ppedropimenta/connected-heart/hardware/kicad/preview/board-bottom.png

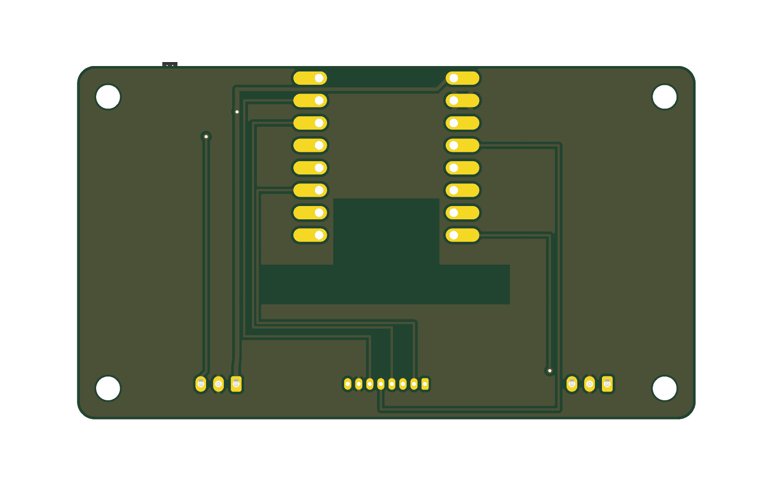
hardware/kicad/preview/board-bottom.png
