ppedropimenta/connected-heart/hardware/kicad/preview/board-top.png

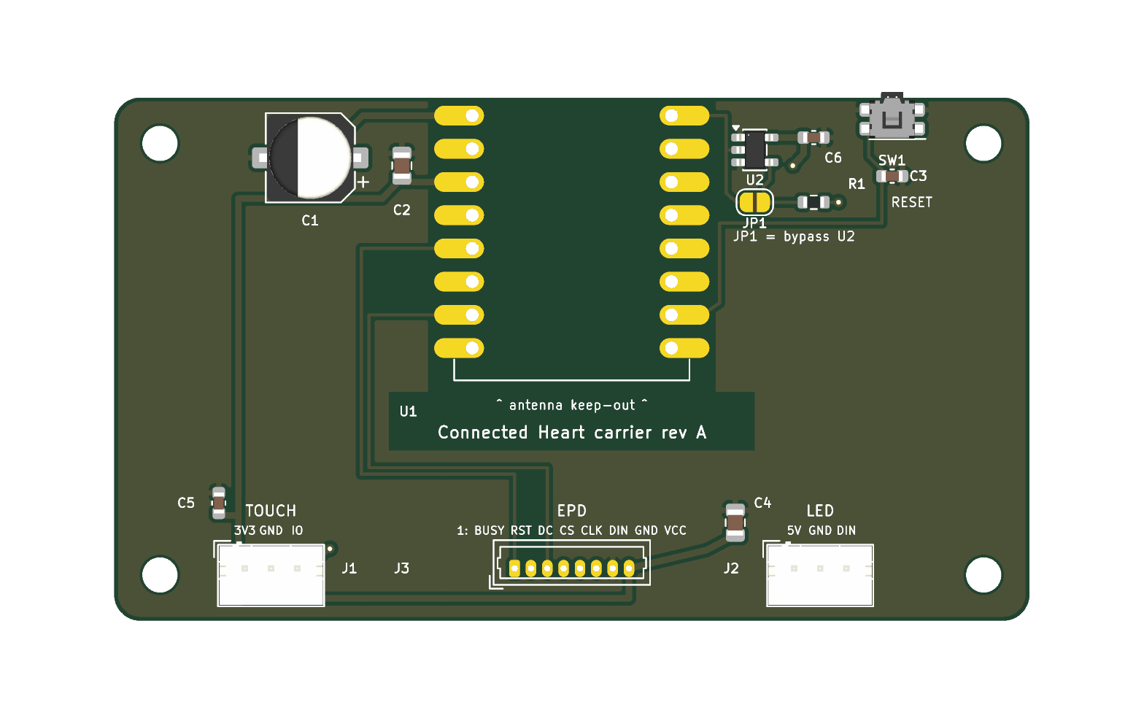
hardware/kicad/preview/board-top.png
