ppedropimenta/connected-heart/hardware/kicad/preview/schematic.pdf

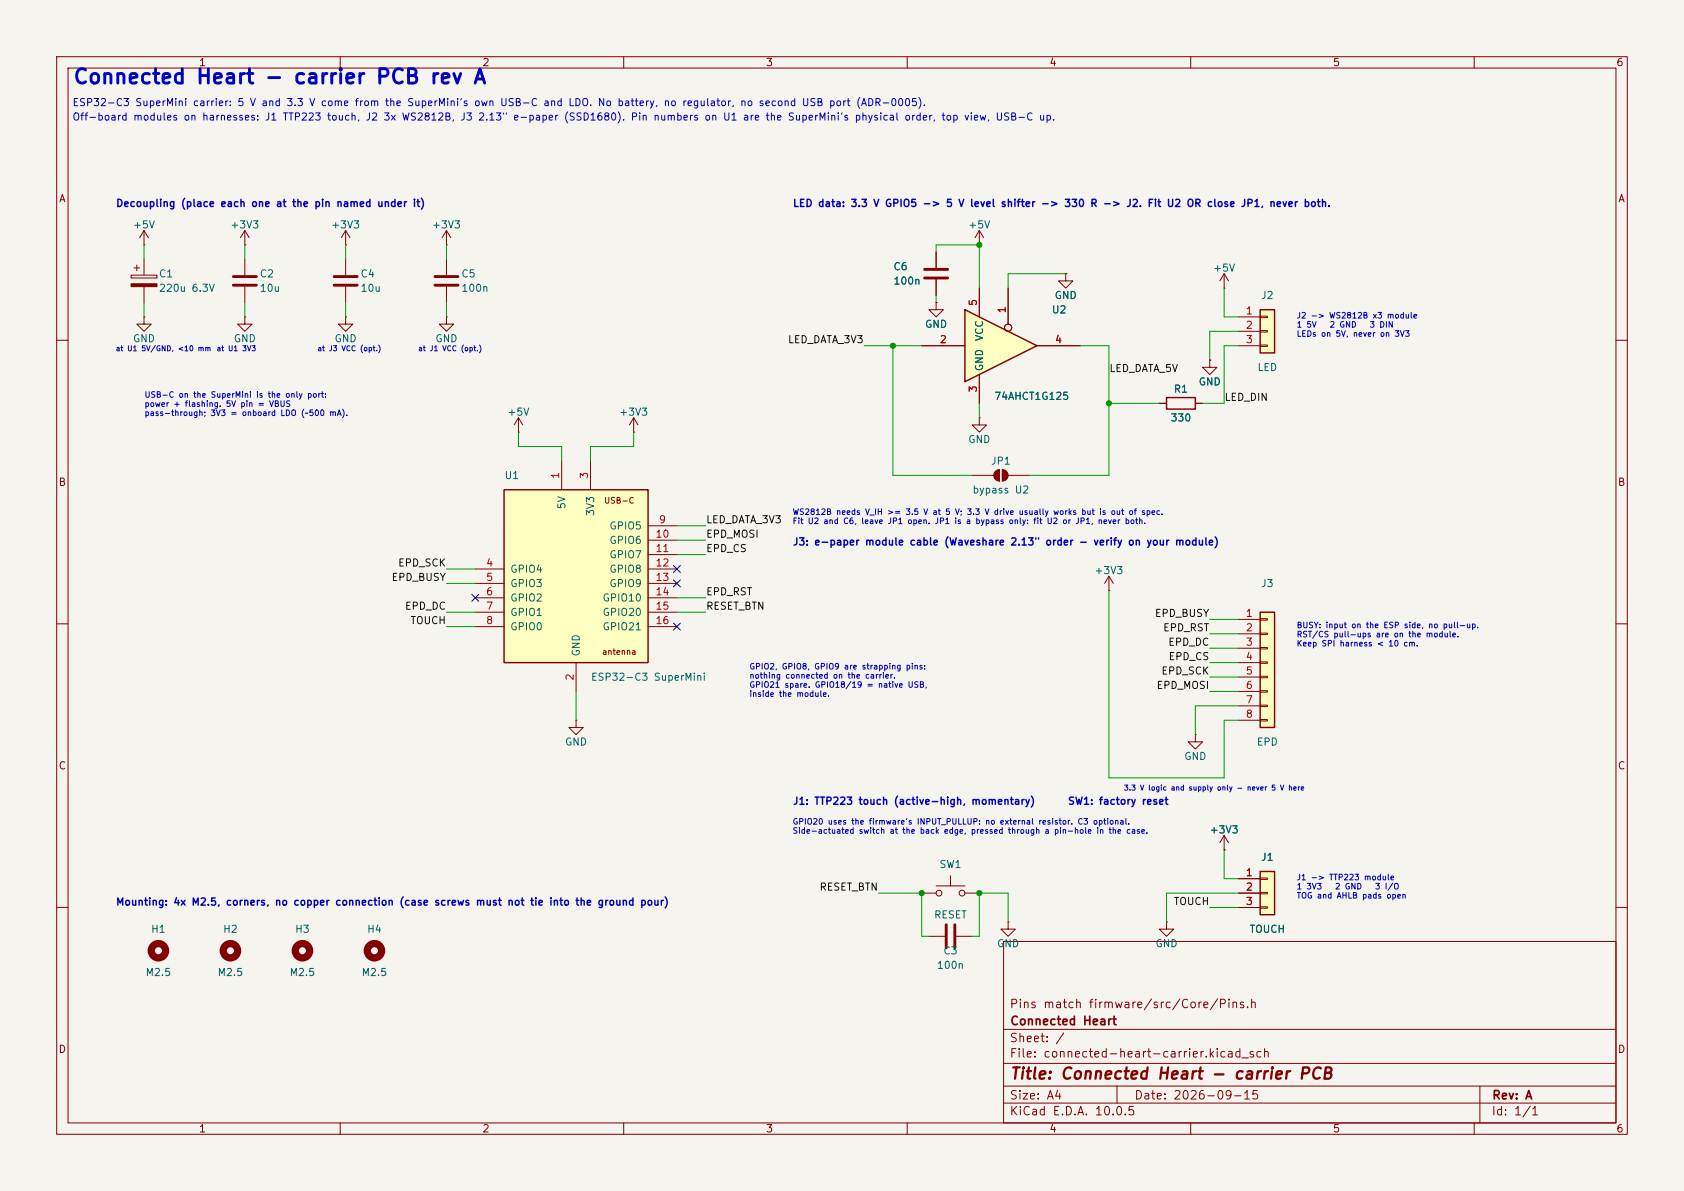
[picture p7: page 1]

pass-through; 3V3 = onboard LDO (~500 mA). at U1 3V3 Connected Heart - carrier PCB rev A
GND +5V GND

inside the module. J3: e-paper module cable (Waveshare 2.13" order - verify on your module) WS2812B needs V_IH >= 3.5 V at 5 V; 3.3 V drive usually works but is out of spec. Fit U2 and C6, leave JP1 open. JP1 is a bypass only: fit U2 or JP1, never both. ESP32-C3 SuperMini carrier: 5 V and 3.3 V come from the SuperMini's own USB-C and LDO. No battery, no regulator, no second USB port (ADR-0005).
Off-board modules on harnesses: J1 TTP223 touch, J2 3x WS2812B, J3 2.13" e-paper (SSD1680). Pin numbers on U1 are the SuperMini's physical order, top view, USB-C up. Decoupling (place each one at the pin named under it)

LEDs on 5V, never on 3V3 GPIO2, GPIO8, GPIO9 are strapping pins: nothing connected on the carrier. GPIO21 spare. GPIO18/19 = native USB,

TOG and AHLB pads open

Pins match firmware/src/Core/Pins.h
Connected Heart
Sheet: /
File: connected-heart-carrier.kicad_sch
Title: Connected Heart - carrier PCB

Size: A4 | Rev: A
KiCad E.D.A. 10.0.5 | Id: 1/1
