ppedropimenta/connected-heart/hardware/kicad/connected-heart-carrier.kicad_sch

## KiCad design hardware/kicad/connected-heart-carrier.kicad_sch (2026-10-23)

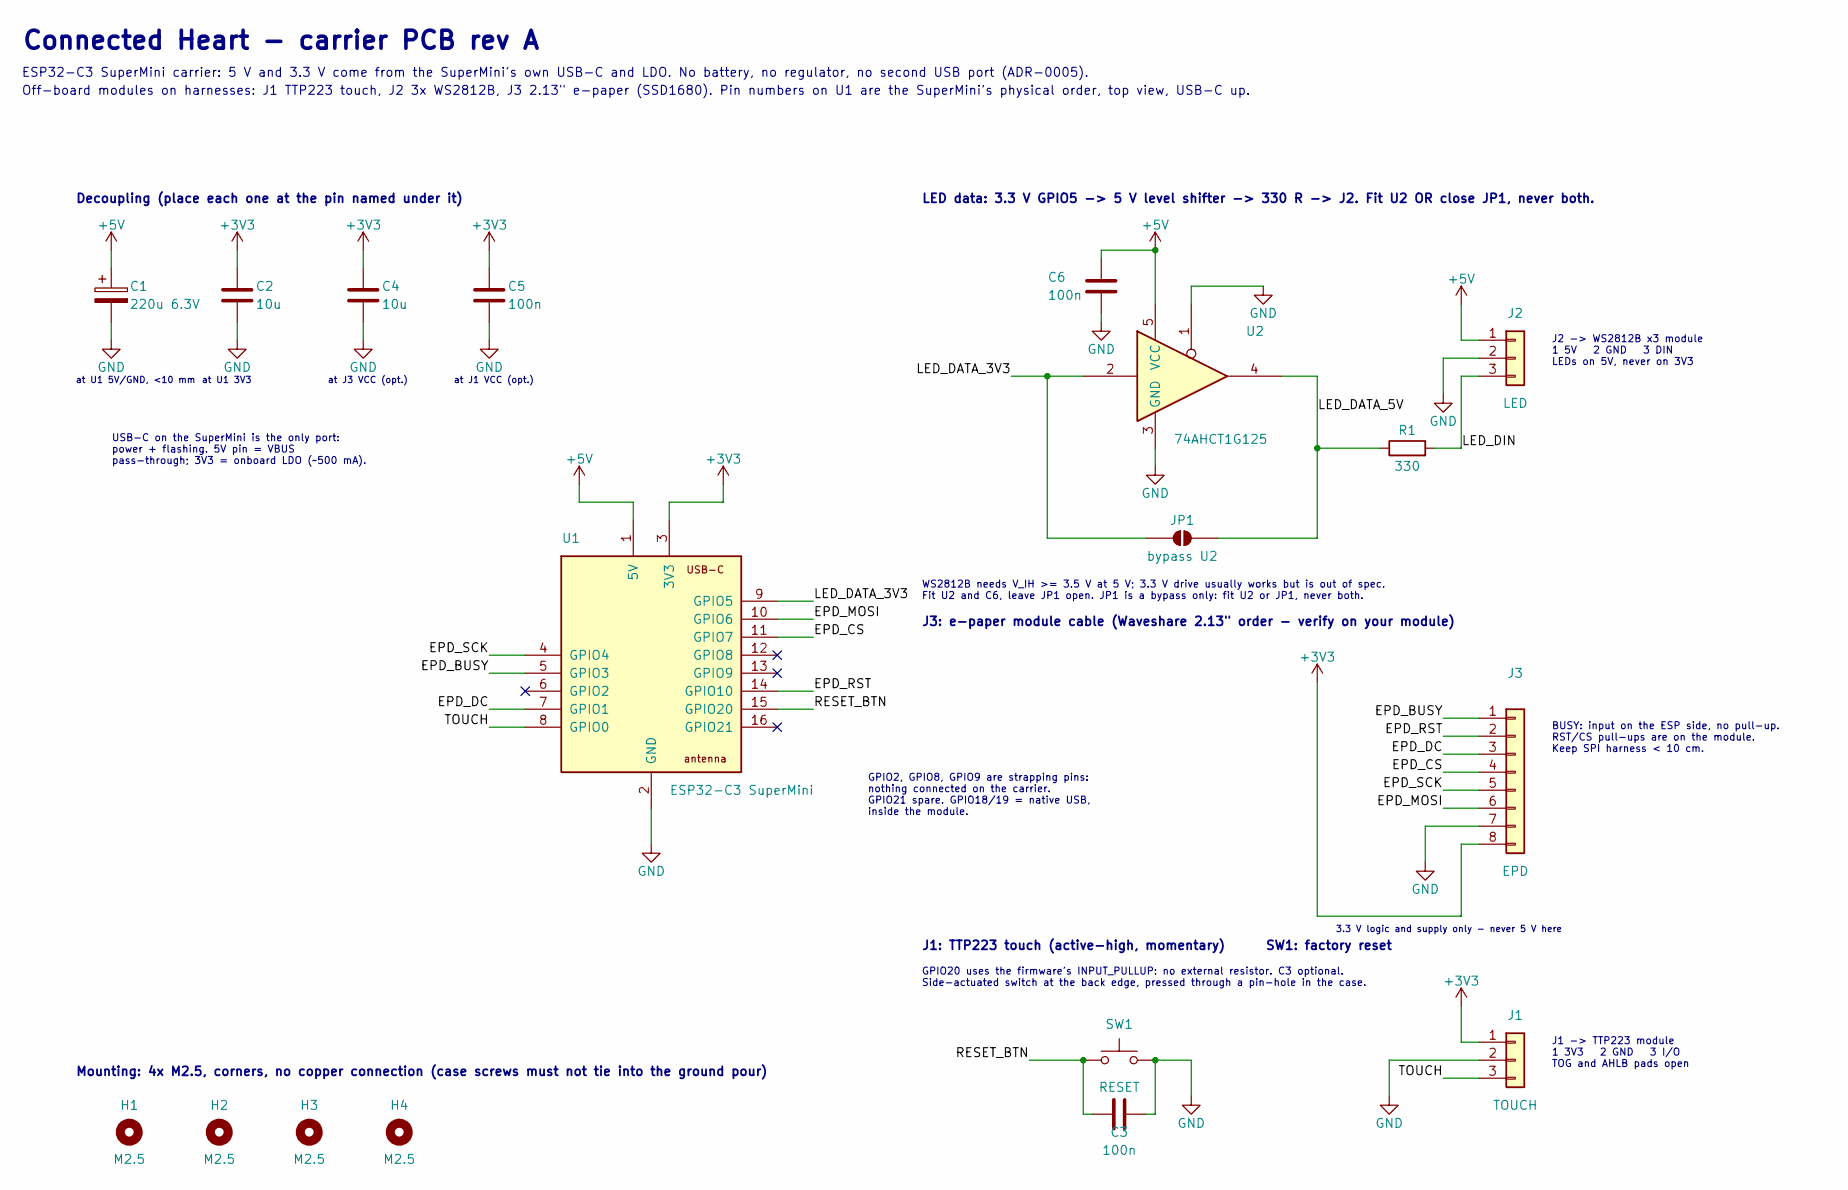
[picture p8: schematic connected-heart-carrier.kicad_sch]

Parts:
C1: 220u 6.3V; CP_Elec_6.3x5.8
C2, C4: 10u; C_0805_2012Metric
C3, C5, C6: 100n; C_0603_1608Metric
H1, H2, H3, H4: M2.5; MountingHole_2.7mm_M2.5
J1: TOUCH; JST_PH_B3B-PH-K_1x03_P2.00mm_Vertical
J2: LED; JST_PH_B3B-PH-K_1x03_P2.00mm_Vertical
J3: EPD; Molex_PicoBlade_53047-0810_1x08_P1.25mm_Vertical
JP1: bypass U2; SolderJumper-2_P1.3mm_Open_RoundedPad1.0x1.5mm
R1: 330; R_0603_1608Metric
SW1: RESET; SW_SPST_EVQP7A
U1: ESP32-C3 SuperMini; ESP32-C3_SuperMini
U2: 74AHCT1G125; SOT-23-5

Connections:
+3V3: C2.1, C4.1, C5.1, J1.1, J3.8, U1.3 (3V3)
+5V: C1.1, C6.1, J2.1, U1.1 (5V), U2.5 (VCC)
EPD_BUSY: J3.1, U1.5 (GPIO3)
EPD_CS: J3.4, U1.11 (GPIO7)
EPD_DC: J3.3, U1.7 (GPIO1)
EPD_MOSI: J3.6, U1.10 (GPIO6)
EPD_RST: J3.2, U1.14 (GPIO10)
EPD_SCK: J3.5, U1.4 (GPIO4)
GND: C1.2, C2.2, C3.2, C4.2, C5.2, C6.2, J1.2, J2.2, J3.7, SW1.2, U1.2 (GND), U2.1, U2.3 (GND)
LED_DATA_3V3: JP1.1 (A), U1.9 (GPIO5), U2.2
LED_DATA_5V: JP1.2 (B), R1.1, U2.4
LED_DIN: J2.3, R1.2
RESET_BTN: C3.1, SW1.1, U1.15 (GPIO20)
TOUCH: J1.3, U1.8 (GPIO0)

Notes on the sheet:
Connected Heart - carrier PCB rev A
ESP32-C3 SuperMini carrier: 5 V and 3.3 V come from the SuperMini's own USB-C and LDO. No battery, no regulator, no second USB port (ADR-0005).
Off-board modules on harnesses: J1 TTP223 touch, J2 3x WS2812B, J3 2.13" e-paper (SSD1680). Pin numbers on U1 are the SuperMini's physical order, top view, USB-C up.
GPIO2, GPIO8, GPIO9 are strapping pins: nothing connected on the carrier. GPIO21 spare. GPIO18/19 = native USB, inside the module.
USB-C on the SuperMini is the only port: power + flashing. 5V pin = VBUS pass-through; 3V3 = onboard LDO (~500 mA).
Decoupling (place each one at the pin named under it)
at U1 5V/GND, <10 mm
at U1 3V3
at J3 VCC (opt.)
at J1 VCC (opt.)
LED data: 3.3 V GPIO5 -> 5 V level shifter -> 330 R -> J2. Fit U2 OR close JP1, never both.
J2 -> WS2812B x3 module 1 5V 2 GND 3 DIN LEDs on 5V, never on 3V3
WS2812B needs V_IH >= 3.5 V at 5 V; 3.3 V drive usually works but is out of spec. Fit U2 and C6, leave JP1 open. JP1 is a bypass only: fit U2 or JP1, never both.
J3: e-paper module cable (Waveshare 2.13" order - verify on your module)
BUSY: input on the ESP side, no pull-up. RST/CS pull-ups are on the module. Keep SPI harness < 10 cm.
3.3 V logic and supply only - never 5 V here
J1: TTP223 touch (active-high, momentary) SW1: factory reset
J1 -> TTP223 module 1 3V3 2 GND 3 I/O TOG and AHLB pads open
GPIO20 uses the firmware's INPUT_PULLUP: no external resistor. C3 optional. Side-actuated switch at the back edge, pressed through a pin-hole in the case.
Mounting: 4x M2.5, corners, no copper connection (case screws must not tie into the ground pour)
