ppedropimenta/connected-heart/(commit log)

2026-07-25 Initial ESP32-C3 PlatformIO setup
2026-07-25 Core modules and LED control implemented
2026-09-10 Split message domain model: Feeling apart from kind, drop the heap
    MessageType conflated which feeling a message carries with where its
    text comes from, which produced a dead catalog case and let a
    default-constructed HeartMessage exist only to be rejected. Feeling
    now carries just the five sentiments, MessageKind distinguishes a
    Custom Message from a Predefined one, and HeartMessage exposes two
    constructors instead of a default one, so an incomplete message
    cannot be built.
    HeartMessage's text is now a fixed buffer behind a union with Feeling
    (both trivial, so no manual lifetime handling is needed), removing
    Arduino String and the heap allocation that came with it from the
    messa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
    [Config.h]
2026-09-10 Host build and the Application seam
    Application owned concrete hardware and did nothing; it now takes a
    DisplayRenderer, Led, TouchSensor, MessageSource, and Clock through its
    constructor and coordinates them, so the product's behaviour can be
    driven by fakes and asserted on without a board.
    DisplayRenderer becomes a pure-virtual interface (the e-paper render
    method is a template and so cannot be virtual itself); the existing
    e-paper implementation moves unchanged into EpaperDisplayRenderer. Led
    and TouchSensor gain the same small interface shape. Time is read
    through a new Clock interface instead of Arduino's millis(), so reveal
    and timeout behaviour is testable without waiting i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
2026-09-10 Wire the receive path: serial message source and real entry point
2026-09-10 Implement the notification LED: pattern selection and real NeoPixel driver
    Adds LedPattern::Setup and a pure LedPatternSelector (DeviceState +
    ConnectionState -> LedPattern) that Application::enterState now calls
    instead of hardcoding a pattern per case, closing the precedence rule
    that ConnectionError only replaces a pattern that would otherwise be
    Off. NeoPixelLed replaces main.cpp's NullLed placeholder, rendering
    each pattern as a colour and rhythm (breathe, blink, or a two-pulse
    thump) on Pins::NotificationLed::LED_DATA; it is excluded from the
    native build alongside the project's other hardware-only adapters.
    Pattern selection is covered by a new test_led_pattern_selector host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
    [Config.h, LedPatternSelector.cpp, LedPatternSelector.h, NeoPixelLed.cpp, NeoPixelLed.h, main.cpp]
2026-09-11 Rewire notification LED to GPIO5 and touch sensor to GPIO0
    Matches the actual bench wiring. GpioTouchSensor's header comment
    referenced GPIO21 by name; pointed it at the Pins::Touch::TOUCH
    constant instead so it can't drift out of sync with Pins.h again.
2026-09-11 Drive all 3 chained NeoPixels and warm up the notification colour
    Bench feedback: the strip is 3 WS2812s in sequence, not 1, and only
    the first was lighting. setColorAtBrightness now fills the whole
    chain instead of addressing pixel 0 alone.
    Also swaps NotificationPulse's base colour from a pink (255, 20, 90)
    to the same warm red RevealHeartbeat uses (255, 25, 0), so the pulse
    reads as the heart's own colour breathing gently rather than a
    different hue. Connecting's blue was confirmed good as-is.
    [NeoPixelLed.cpp]
2026-09-11 Persist the Current Message across a power cycle
2026-09-11 Wire real WiFi: WifiManager, credential seam, and the connection indicator
2026-09-11 Add DEBUG-level logging for WiFi connection details
    WifiManager already logged the significant transitions (connected/
    disconnected) at INFO/WARN. Add LOG_DEBUG detail alongside each: the
    begin() config, the connected IP and RSSI, the WiFi.status() code on a
    drop, and on every throttled retry attempt while disconnected.
2026-09-11 Implement TelegramMessageSource: poll, filter, deliver
2026-09-11 Captive portal provisioning: AP, config page, NVS credentials
    A heart with no stored credentials now raises an open access point and
    serves a configuration page (network scan + password field, both polled
    asynchronously so nothing blocks the LED, touch handling, or the DNS/web
    server). Submitted credentials are only persisted once the connection is
    actually confirmed, so a wrong password never leaves storage looking
    provisioned. main.cpp raises the portal whenever DeviceState is Setup,
    which also covers the automatic recovery path from ConnectionAttemptsExhausted
    for free. The compiled-in bench path stays available behind
    USE_COMPILED_CREDENTIALS.
    [Config.h]
2026-09-14 Recovery: e-paper recovery copy, reset button, and pin-map cleanup
2026-10-23 Portal: use the Connected Heart name and fix Portuguese accents; switch bench port to COM6
2026-10-23 Point comments at the ADRs instead of internal issue numbers
    [Config.h, NeoPixelLed.cpp]
2026-10-23 Add carrier PCB schematic and BOM
    [connected-heart-carrier.kicad_sch]
2026-10-23 Schematic: fit U2, leave JP1 open
    [connected-heart-carrier.kicad_sch]
2026-10-23 README: rev A is built and assembled
2026-10-23 Add photos; keep board layout, fabrication files and enclosure CAD private
2026-10-23 BOM: part numbers from the TME order
2026-10-23 BOM: rewrite the U2 note
2026-10-24 Use device photo with English UI text in README
